IanHarris6/USB3-HUB/Schematics (PDFs)/USB-C-Hub.pdf

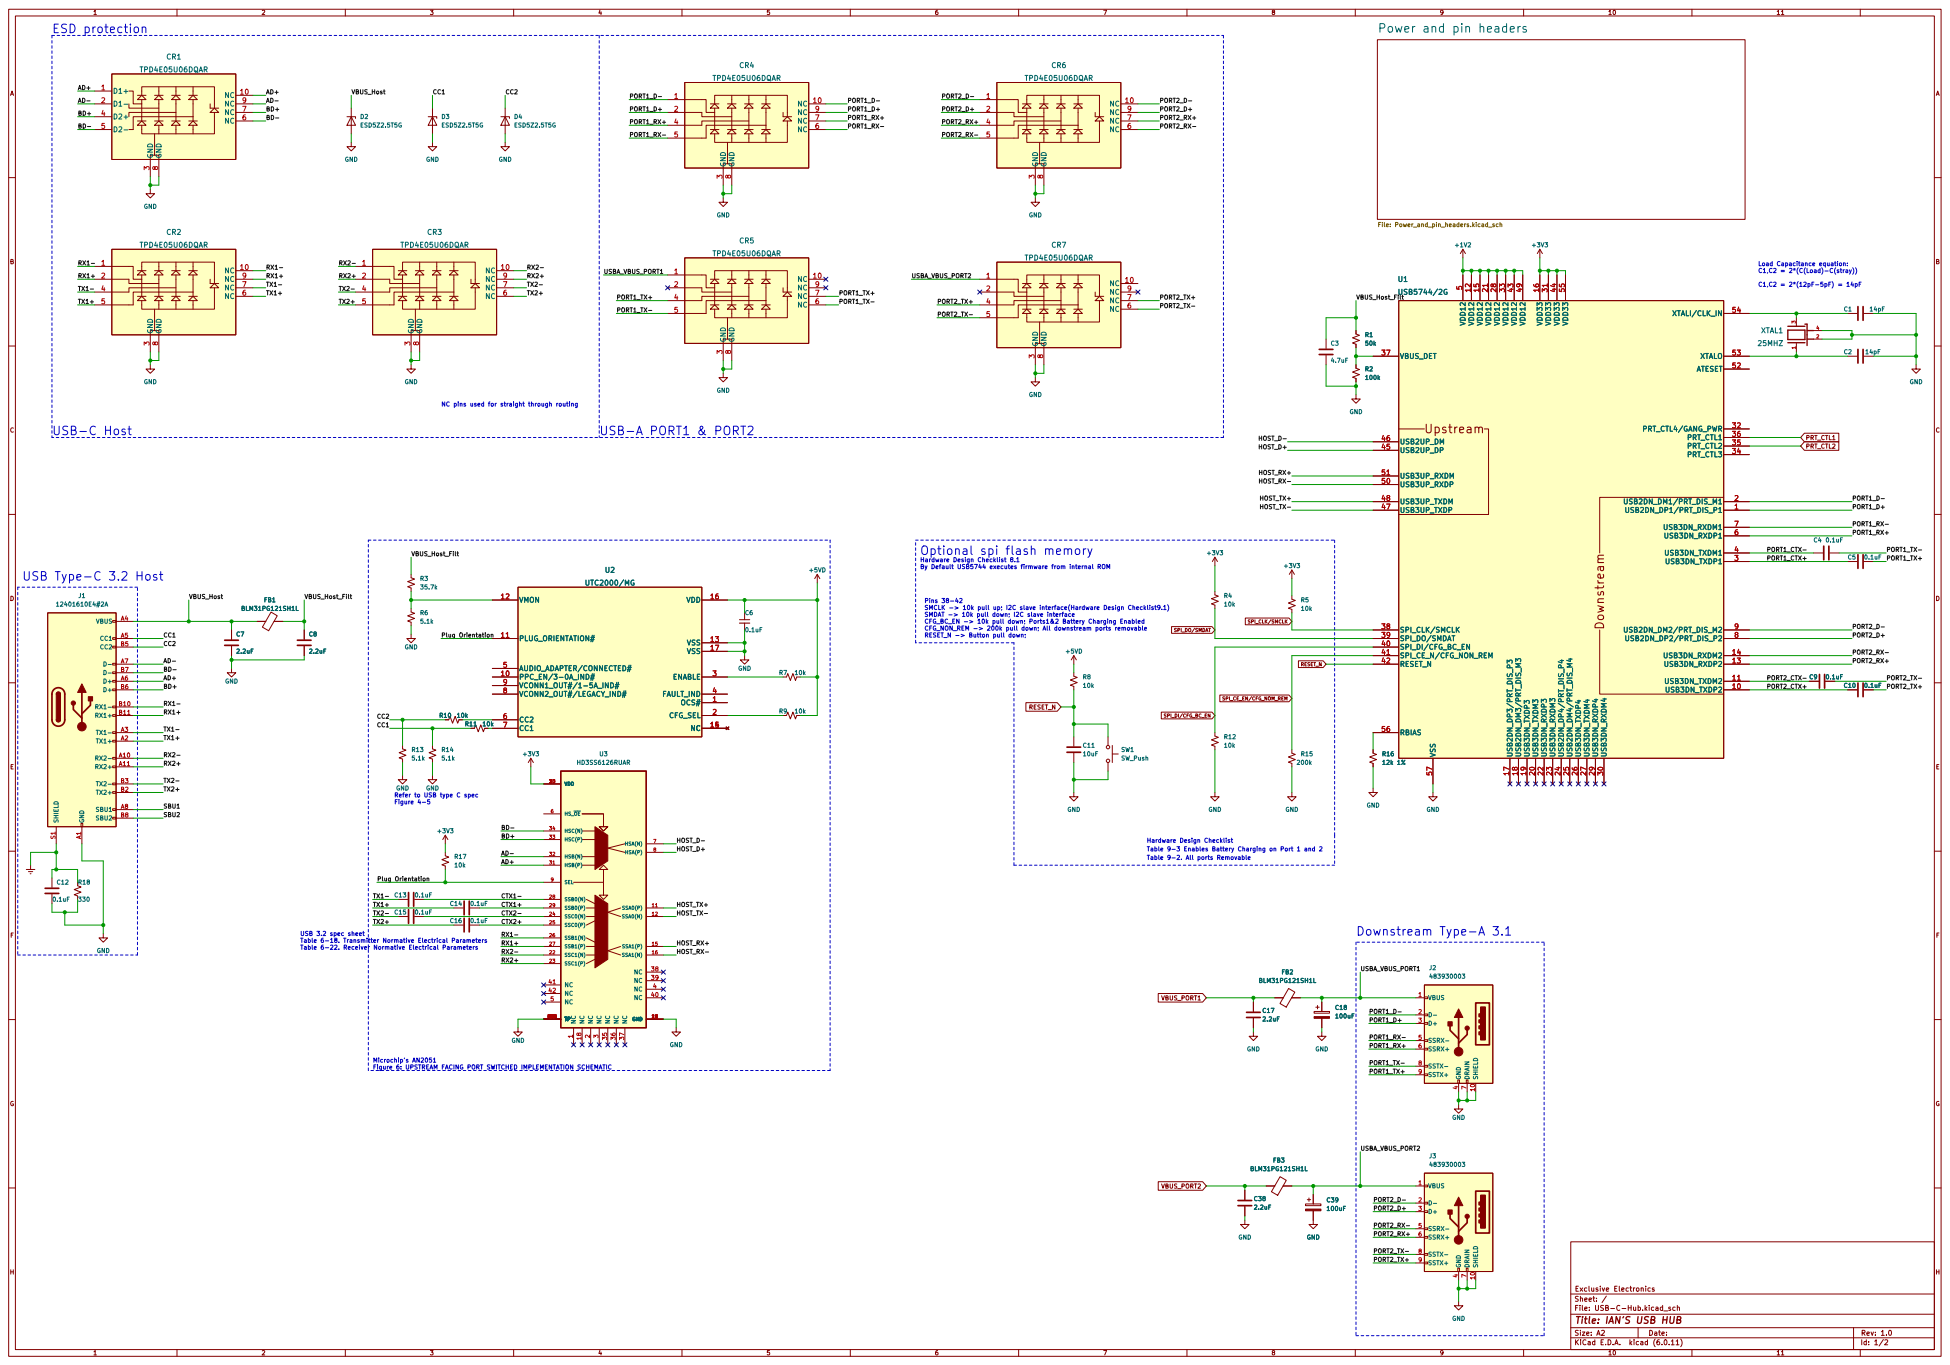
[picture p1: page 1]

3 NC 35 NC 36 NC 37 NC 38 NC 39 NC 4 NC 40 NC 41 NC 42 NC 5 U3 HD3SS6126RUAR

File: USB-C-Hub.kicad_sch Sheet: / Exclusive Electronics

Id: 1/2 Title: IAN'S USB HUB
