IanHarris6/USB3-HUB/Schematics (PDFs)/USB-C-Hub-Power and pin headers.pdf

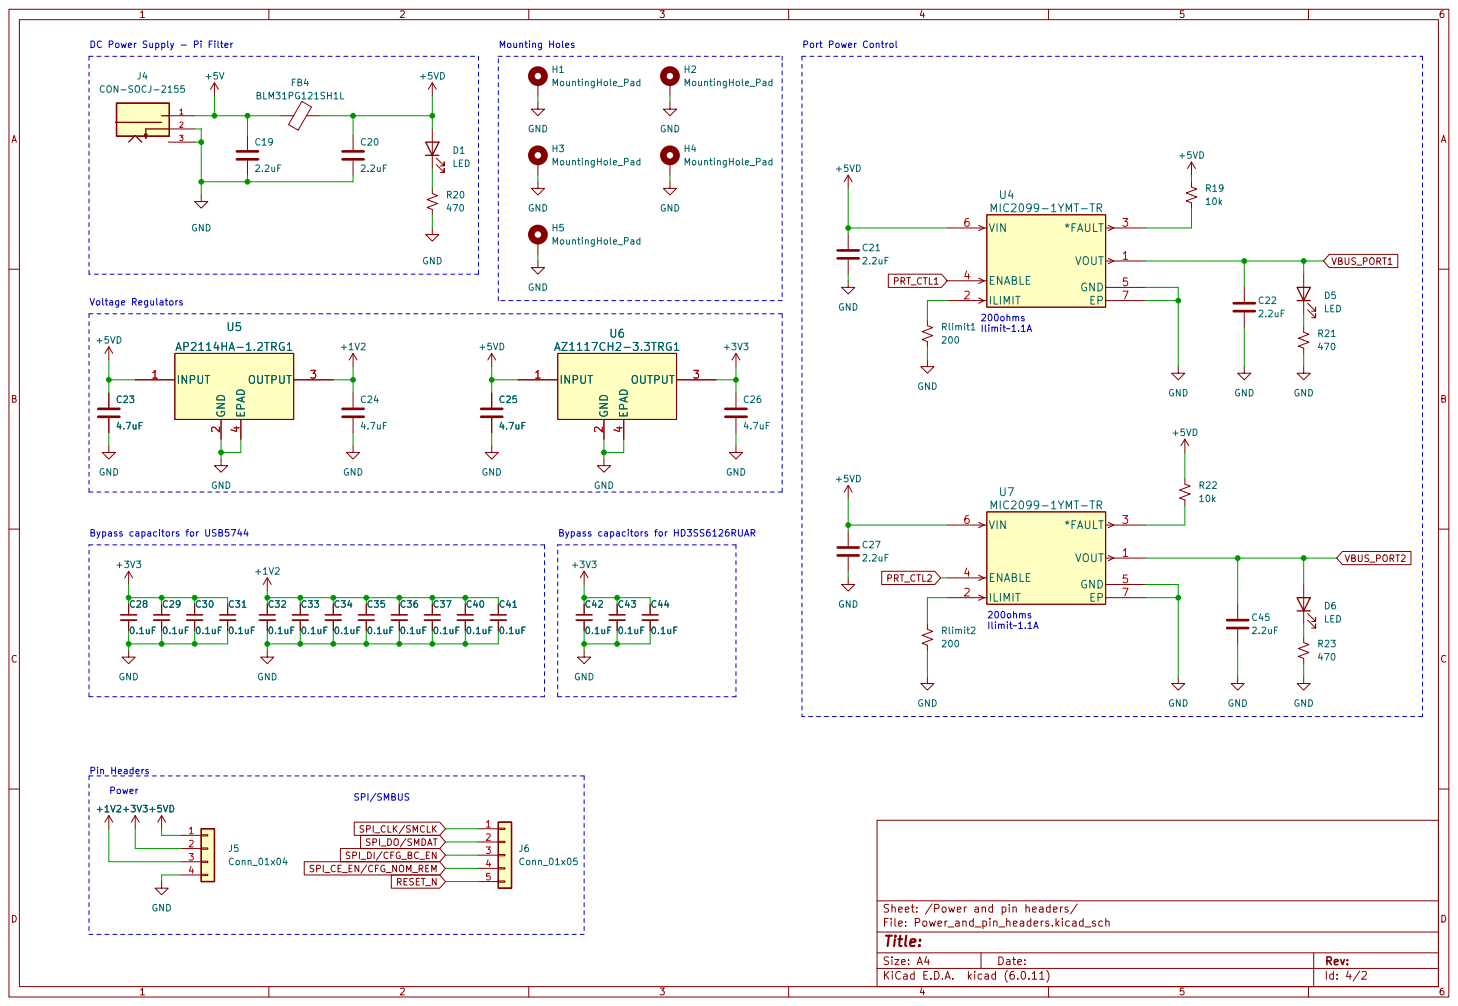
[picture p2: page 1]

DC Power Supply - Pi Filter
