IanHarris6/USB3-HUB/V2/Schematics (PDFs)/USB-C-Hub v2-Power and pin headers.pdf

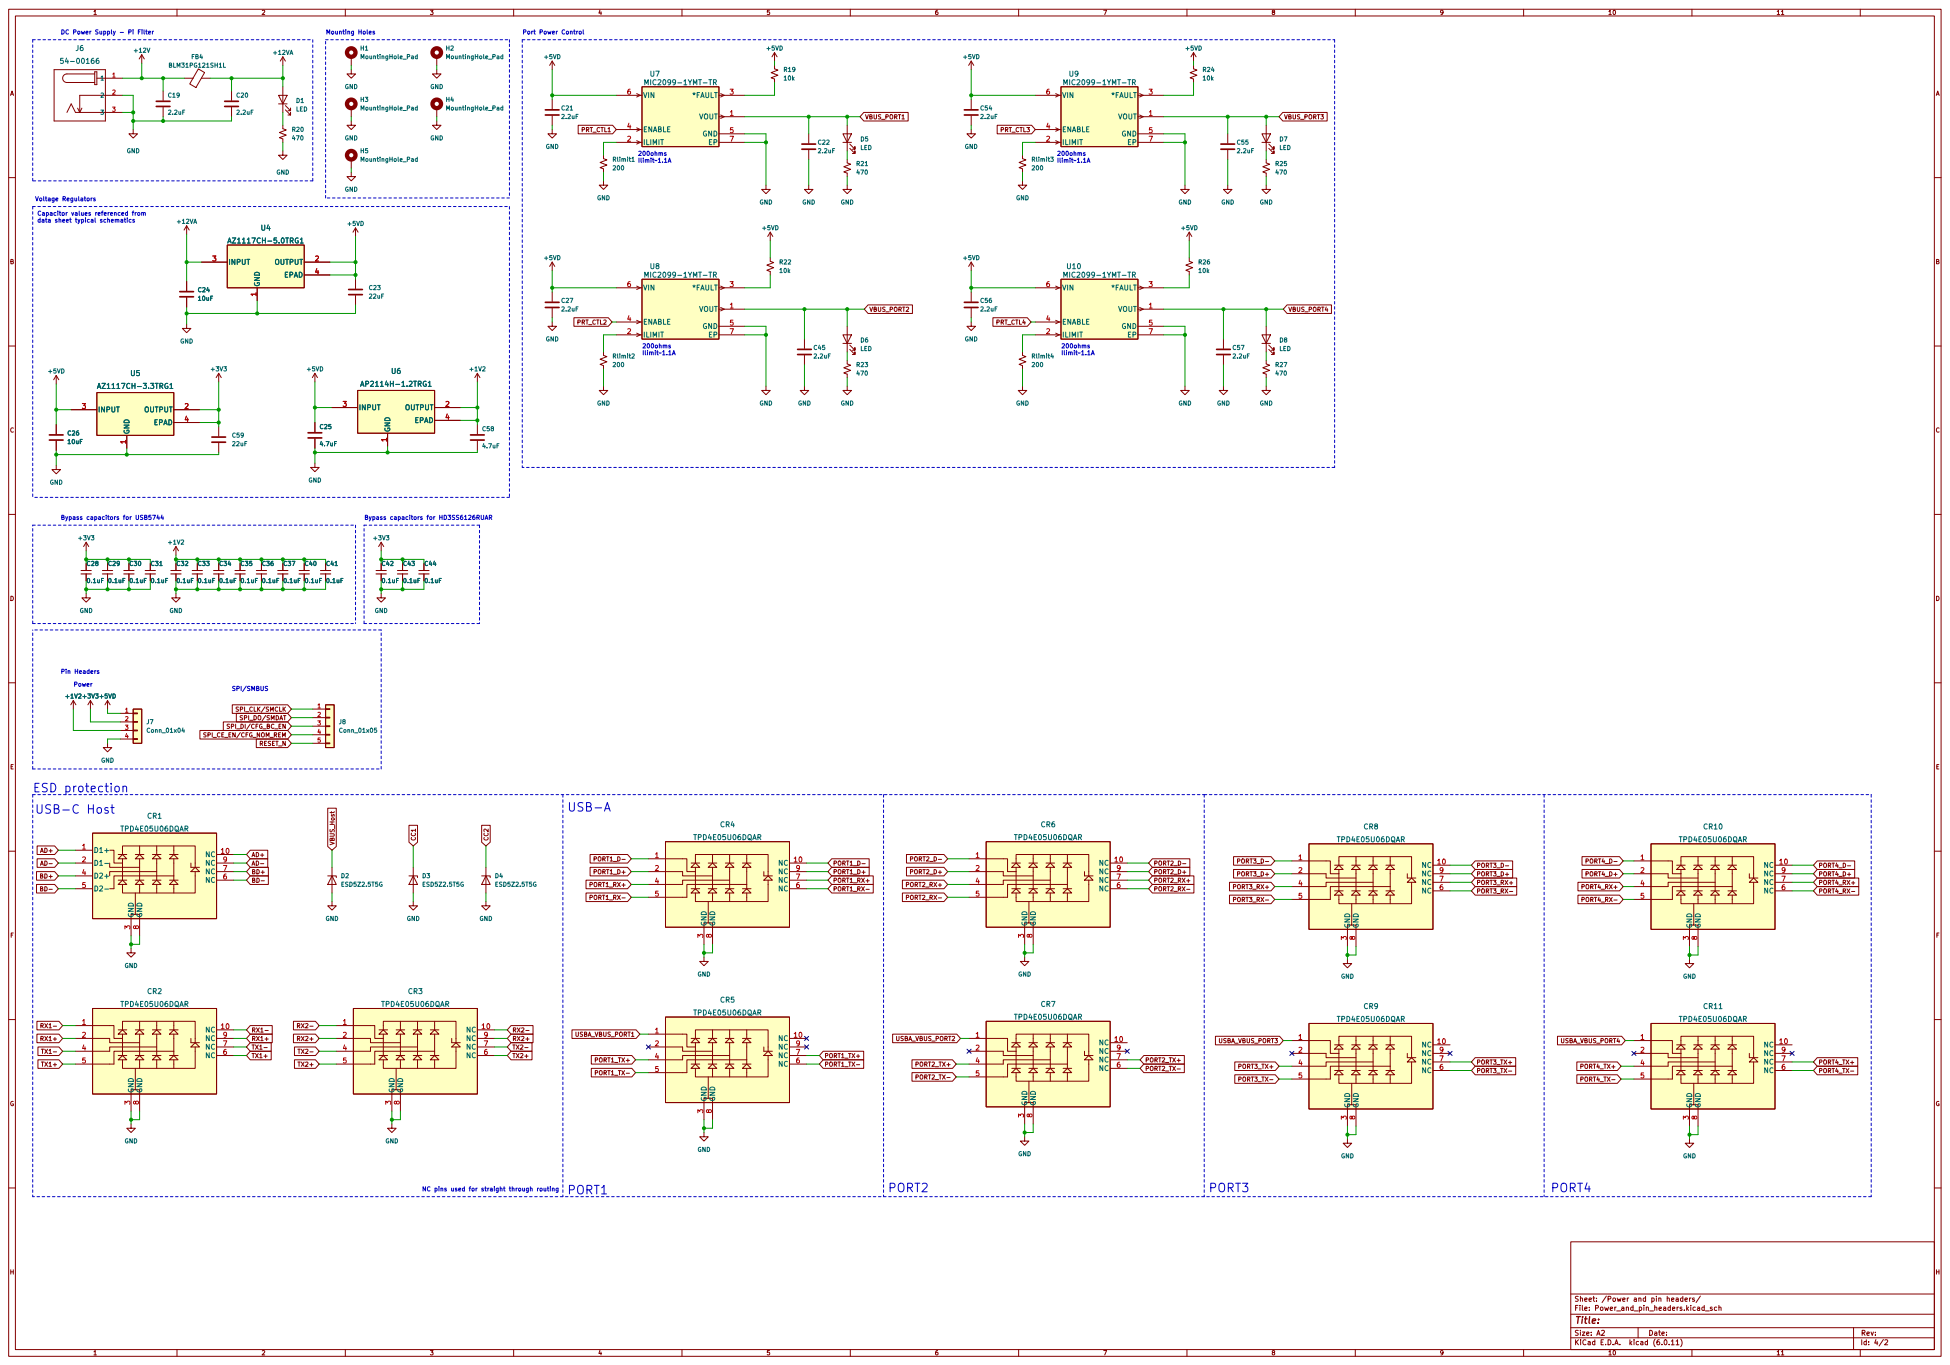
[picture p3: page 1]

Ilimit~1.1A Mounting Holes Voltage Regulators

DC Power Supply - Pi Filter
