IanHarris6/USB3-HUB/V2/Schematics (PDFs)/USB-C-Hub v2.pdf

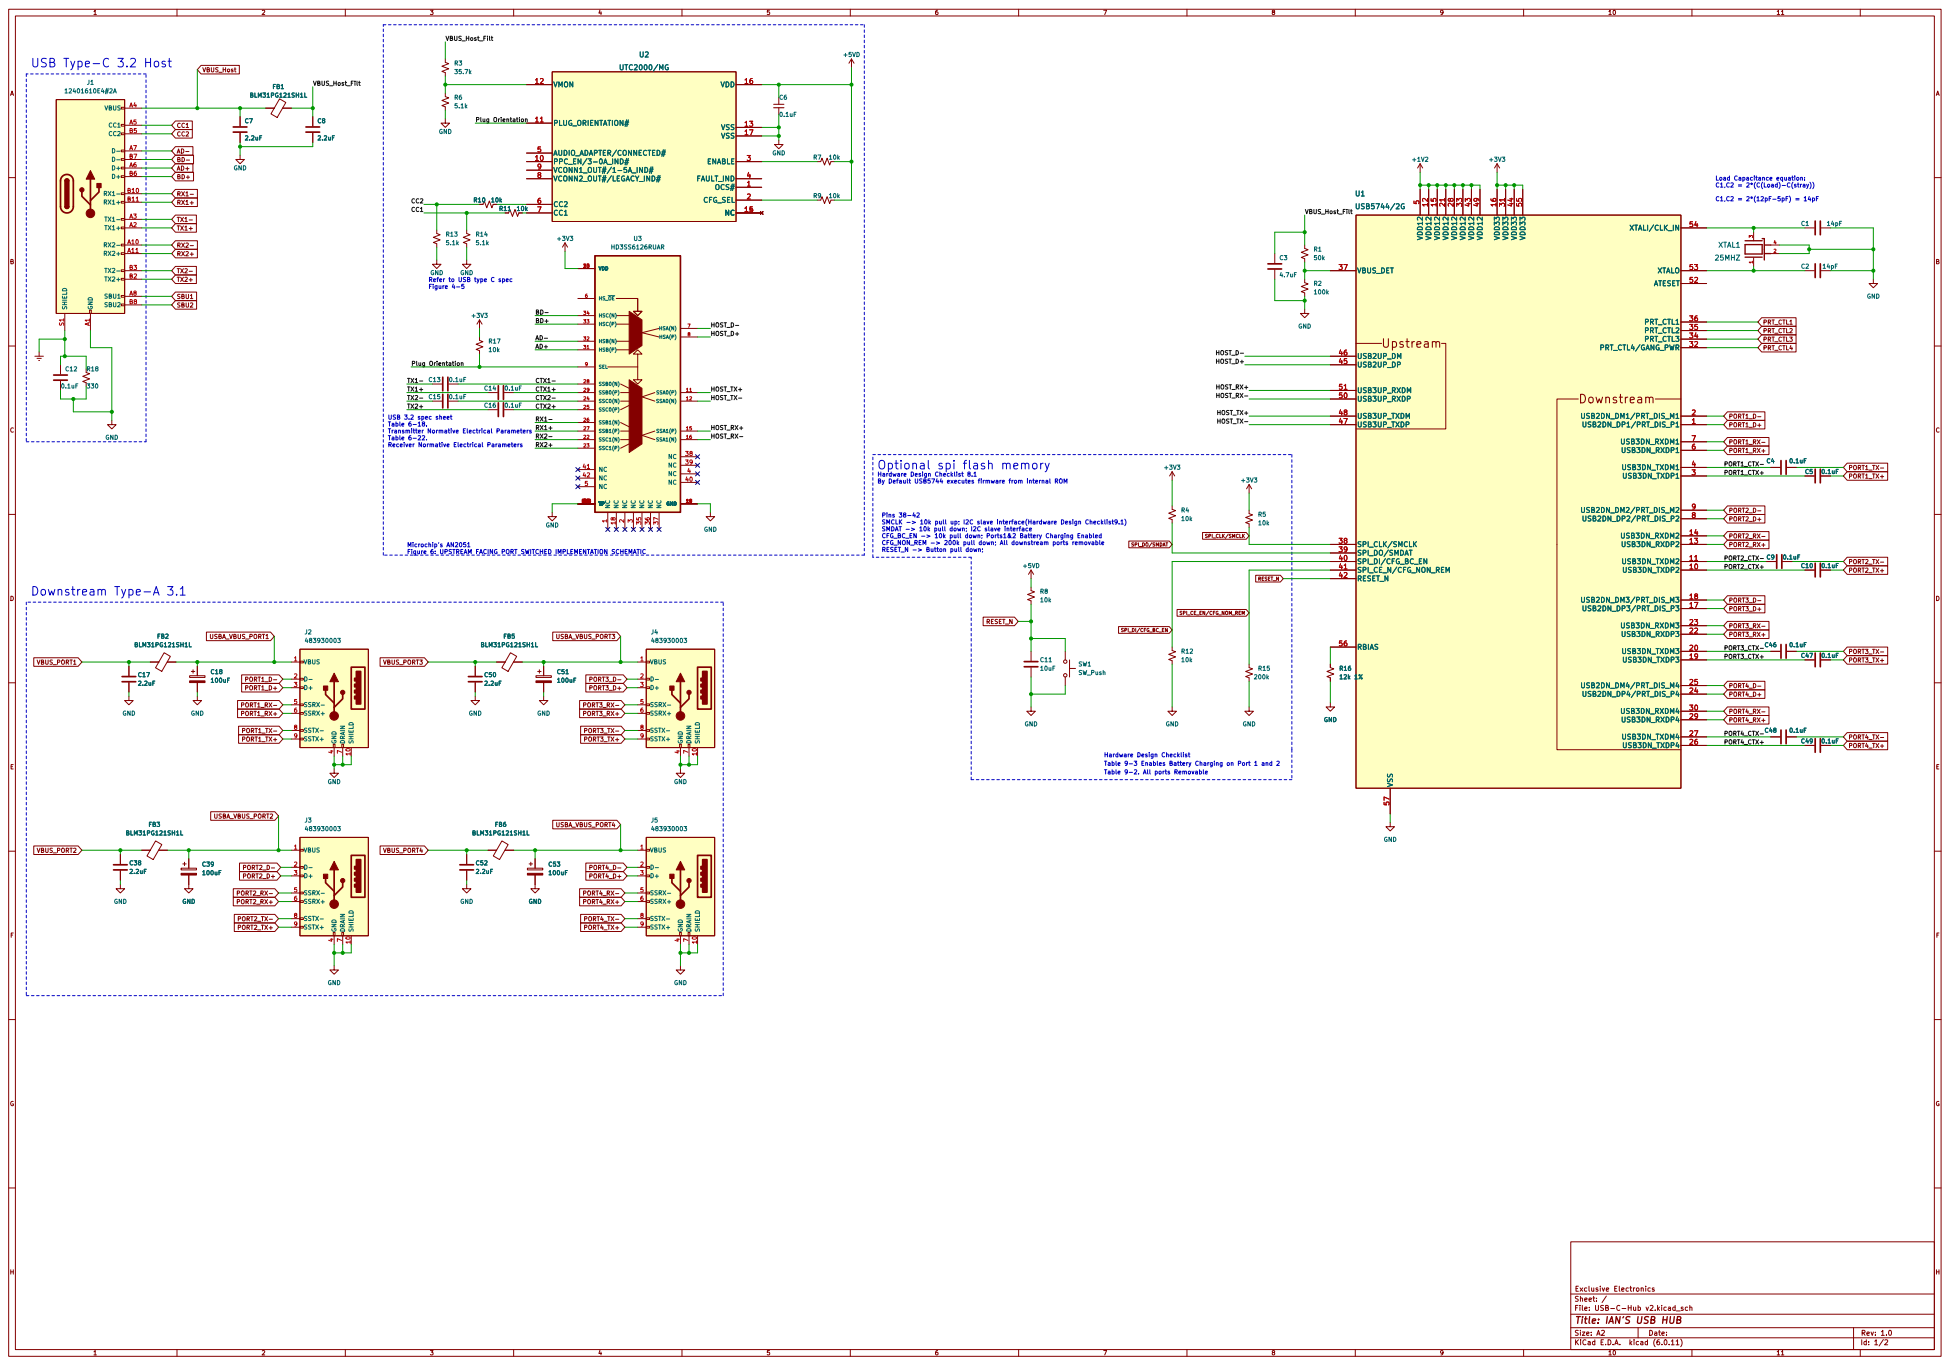
[picture p4: page 1]

VBUS_Host SBU1 SBU2 TX2+ TX2- RX1+ TX1- RX2- RX2+ TX1+ RX1- BD+ CC2 AD- AD+ BD- CC1

3 NC 35 NC 36 NC 37 NC 38 NC 39 NC 4 NC 40 NC 41 NC 42 NC 5 U3 HD3SS6126RUAR
VDD

Optional spi flash memory

Id: 1/2 Title: IAN'S USB HUB


Ilimit~1.1A Mounting Holes Voltage Regulators

DC Power Supply - Pi Filter
