IanHarris6/USB3-HUB/KiCad-Files/USB-C-Hub.kicad_pcb

## KiCad design KiCad-Files/USB-C-Hub.kicad_pcb (2023-09-19)

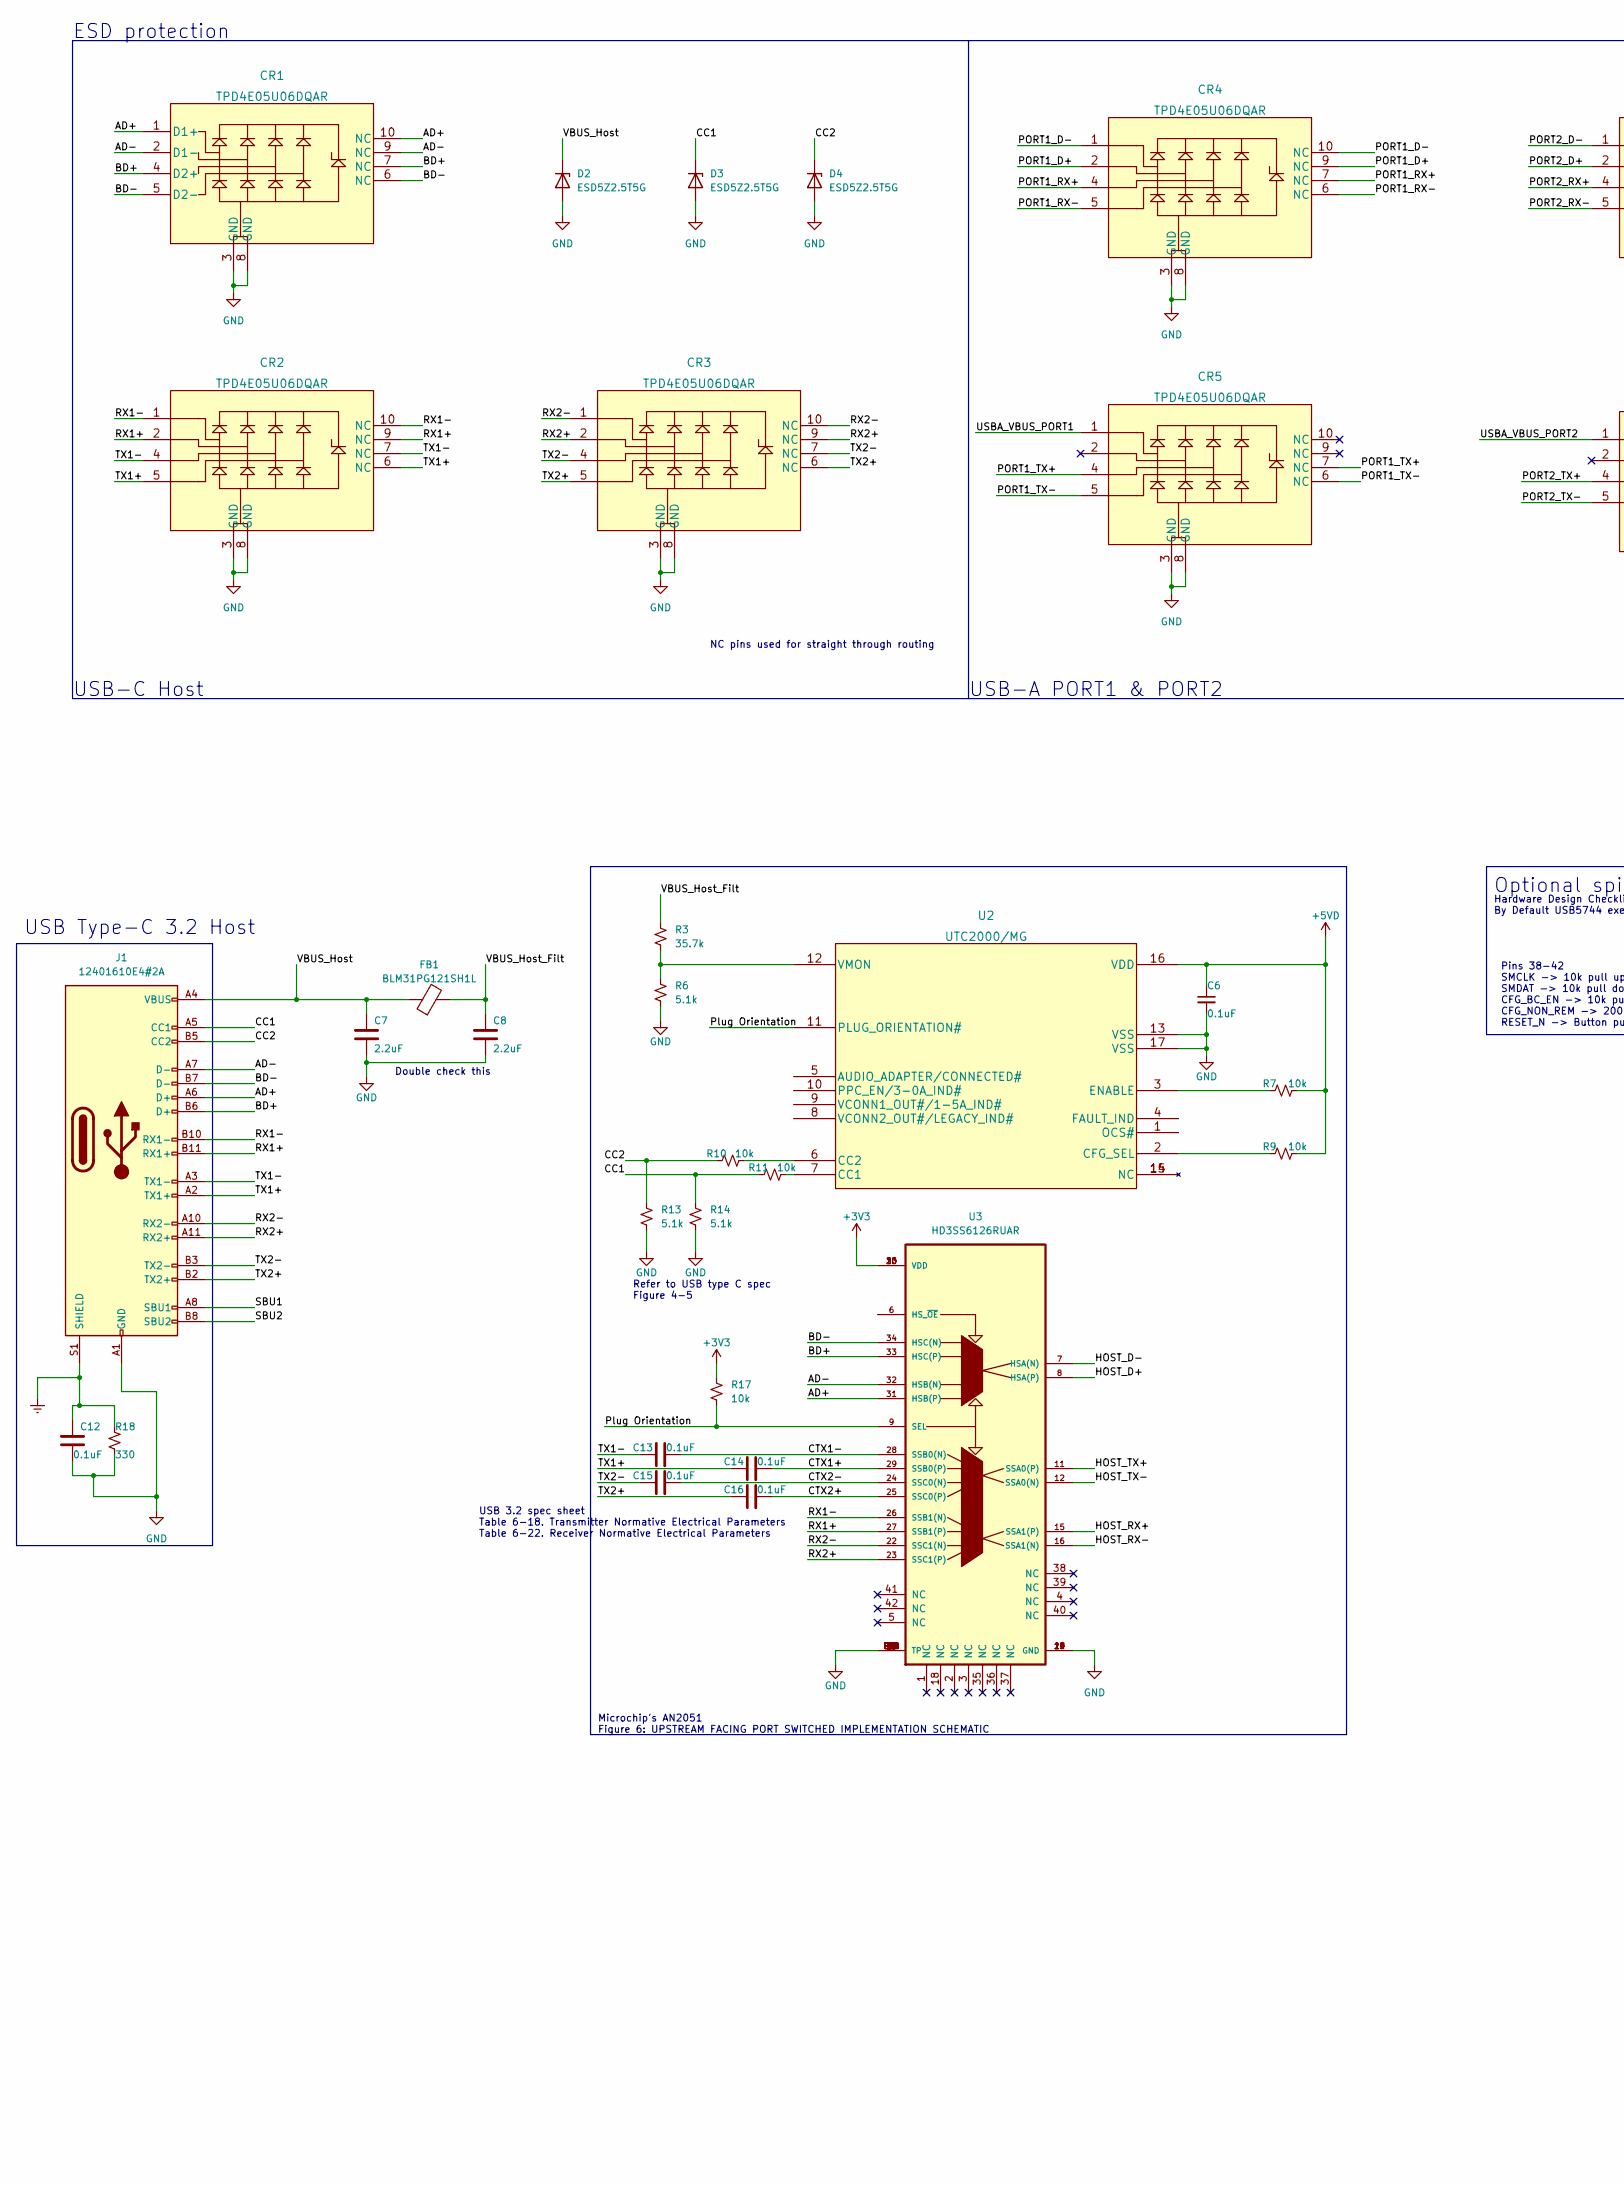
[picture p5: schematic USB-C-Hub.kicad_sch, IAN'S USB HUB, part in row 1, column 1]

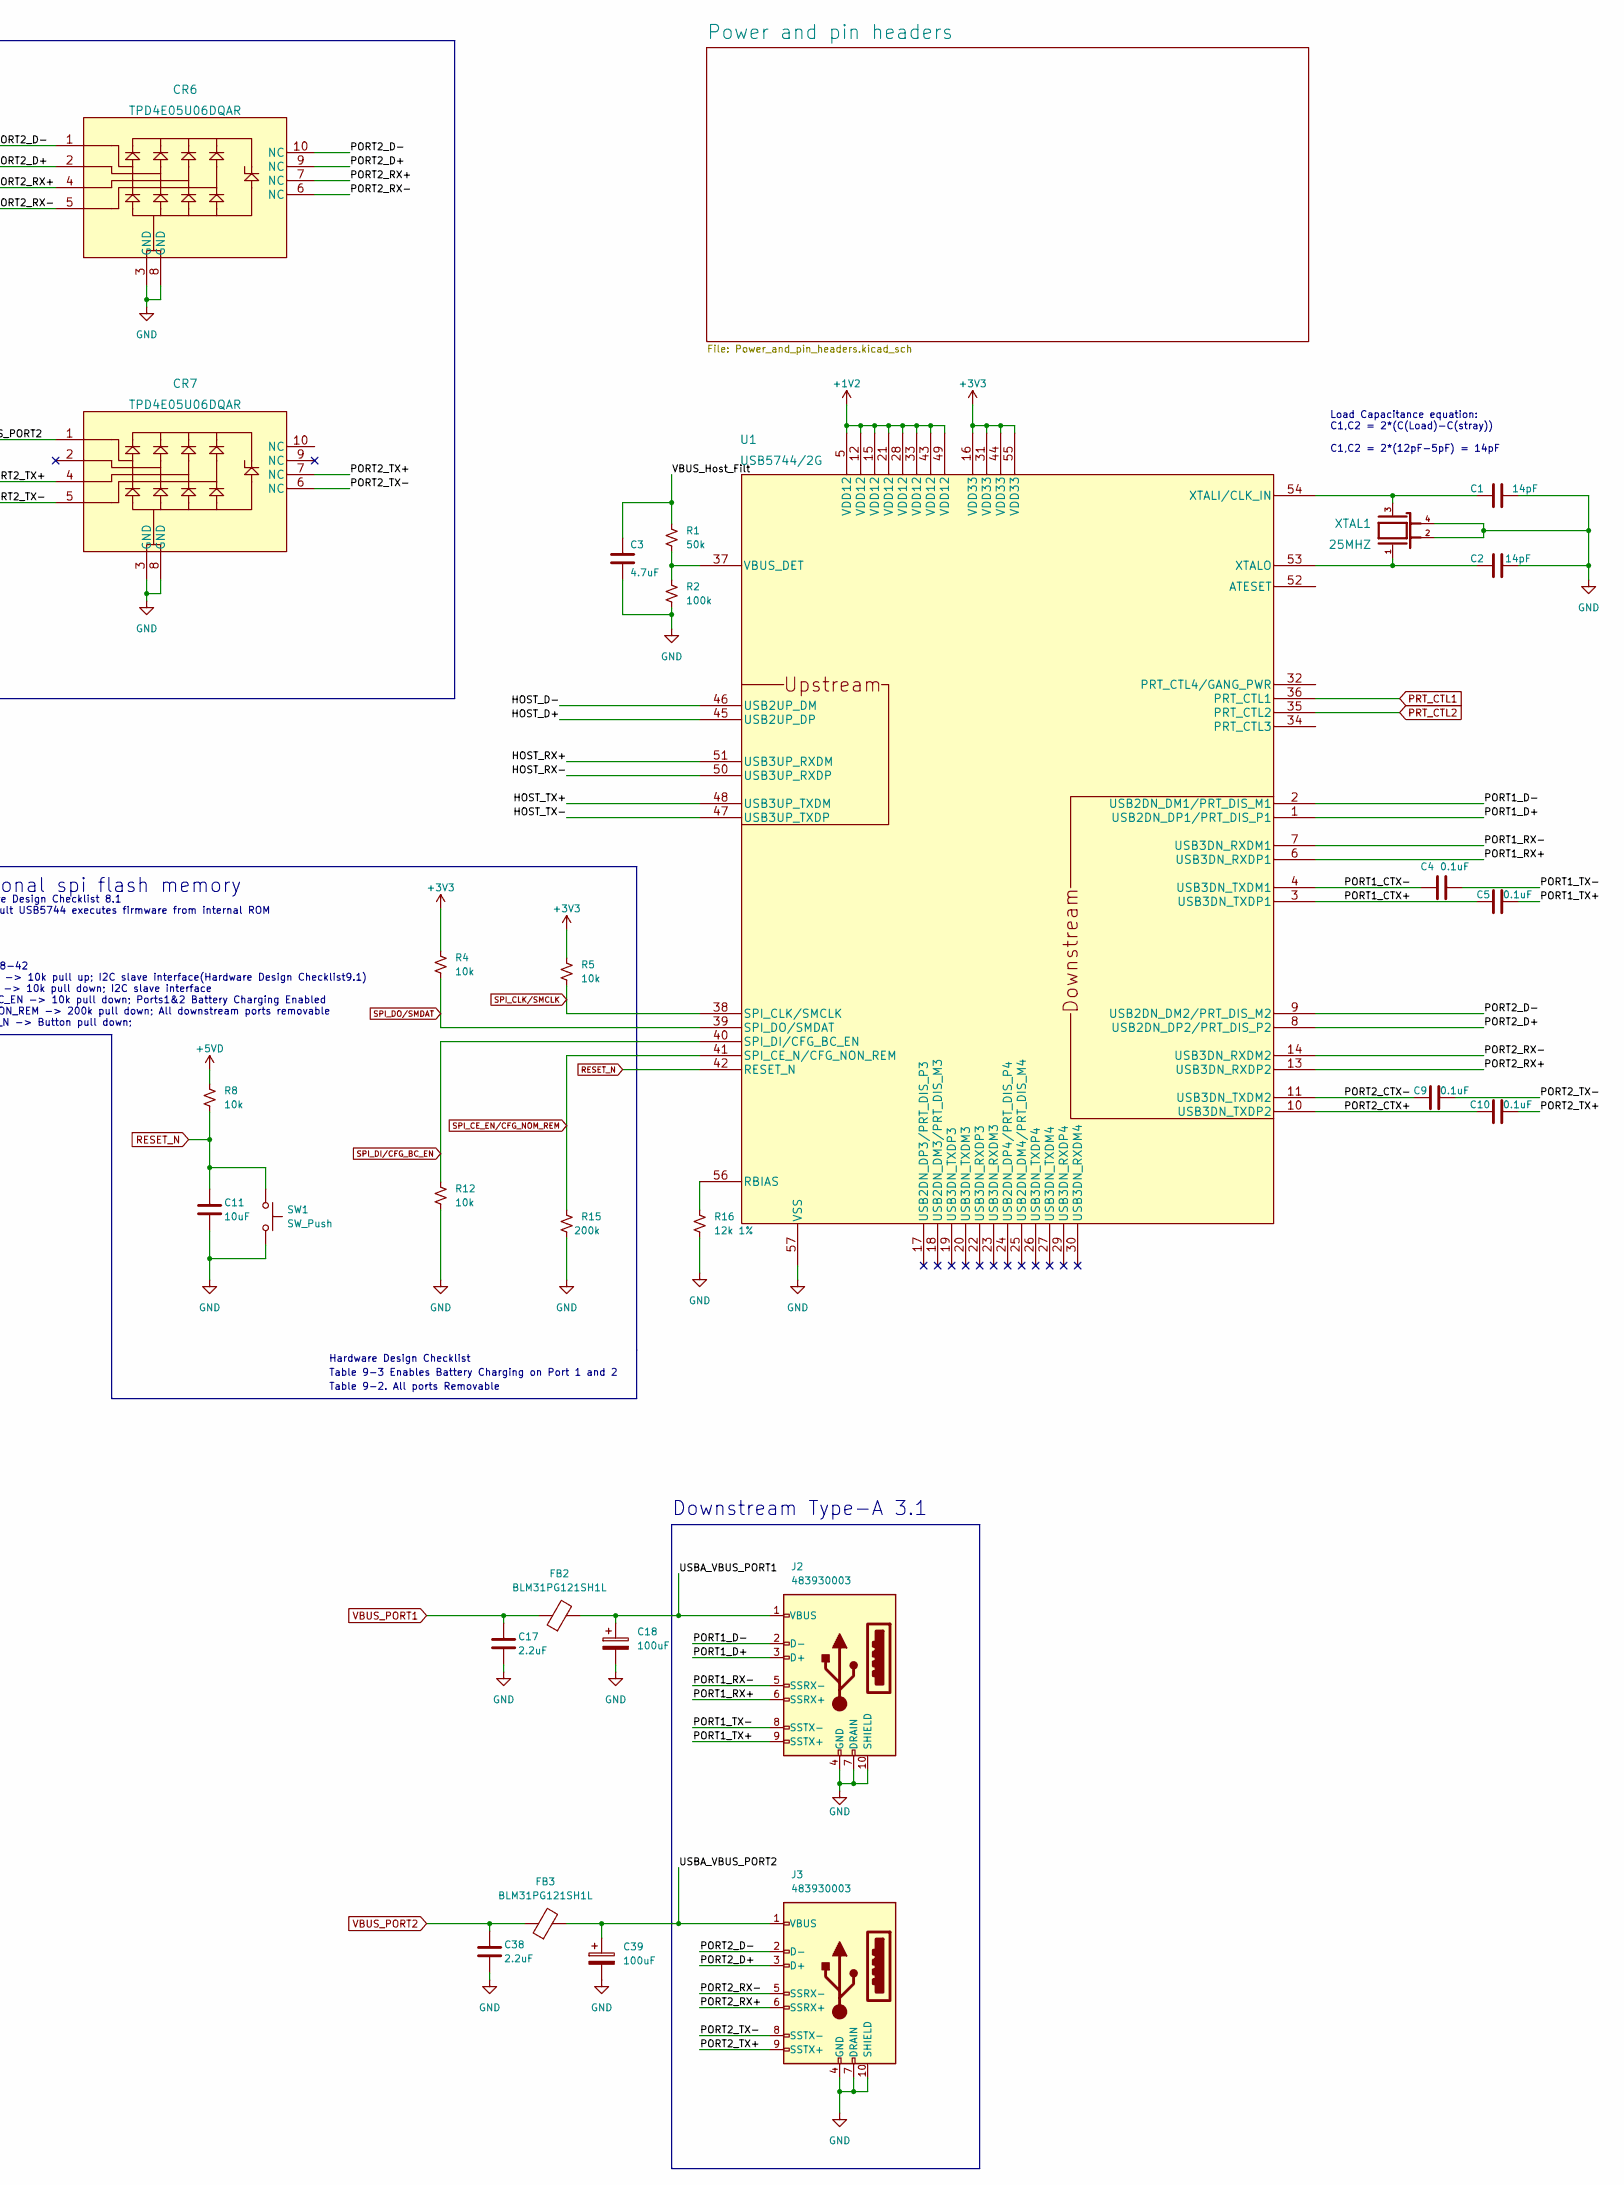
[picture p6: schematic USB-C-Hub.kicad_sch, IAN'S USB HUB, part in row 1, column 2]

Parts:
C1, C2: 14pF; R_0402_1005Metric
C3: 4.7uF; C_0603_1608Metric; MFR# CL10A475KQ8NNNC
C4, C5, C6, C12, C13, C14, C15, C16: 0.1uF; C_0402_1005Metric; MFR# CL05A104KA5NNNC
C7, C8: 2.2uF; C_0603_1608Metric
C9, C10: 0.1uF; C_0402_1005Metric
C11: 10uF; C_0603_1608Metric; MFR# CL10A106KQ8NNNC
C17, C38: 2.2uF; C_0603_1608Metric; MFR# CL10A225KO8NNNC
C18: 100uF; CP_Elec_10x10.5; MFR# MAL215097101E3
C39: 100uF; CP_Elec_10x10.5; MFG# MAL215097101E3
CR1, CR2, CR3, CR4, CR5, CR6, CR7: TPD4E05U06DQAR; USON-10_2.5x1.0mm_P0.5mm
D2, D3, D4: ESD5Z2.5T5G; D_SOD-523
FB1, FB2, FB3: BLM31PG121SH1L; R_1206_3216Metric
J1: 12401610E4#2A; USB_C_Receptacle_Amphenol_12401610E4-2A
J2, J3: 483930003; USB3_A_Molex_48393-001
R1: 50k; R_0402_1005Metric
R2: 100k; R_0402_1005Metric
R3: 35.7k; R_0402_1005Metric
R4, R5, R7, R8, R9, R10, R11, R12, R17: 10k; R_0402_1005Metric
R6, R13, R14: 5.1k; R_0402_1005Metric
R15: 200k; R_0402_1005Metric; MFG# RC0402JR-07200KL
R16: 12k 1%; R_0402_1005Metric
R18: 330; R_0402_1005Metric
SW1: SW_Push; SW_SPST_PTS645; MFR# PTS645SK43SMTR92 LFS
U1: USB5744/2G; VQFN56_2G_MCH
U2: UTC2000/MG; 16-pinQFN3x3; MFR# UTC2000/MG
U3: HD3SS6126RUAR; QFN50P900X350X80-43N
XTAL1: 25MHZ; ECS-250-12-33Q-JES-TR_ECS; MFR# ECS-250-12-33Q-JES-TR

Connections:
+1V2: U1.5 (VDD12), U1.12 (VDD12), U1.15 (VDD12), U1.21 (VDD12), U1.28 (VDD12), U1.33 (VDD12), U1.43 (VDD12), U1.49 (VDD12); also elsewhere on the board
+3V3: R4.1, R5.1, R17.1, U1.16 (VDD33), U1.31 (VDD33), U1.44 (VDD33), U1.55 (VDD33), U3.13 (VDD), U3.20 (VDD), U3.30 (VDD); also elsewhere on the board
+5VD: C6.1, R7.1, R8.1, R9.1, U2.16 (VDD); also elsewhere on the board
/AD+: CR1.1 (D1+), CR1.10 (NC), J1.A6 (D+), U3.31 (HSB(P))
/AD-: CR1.2 (D1-), CR1.9 (NC), J1.A7 (D-), U3.32 (HSB(N))
/BD+: CR1.4 (D2+), CR1.7 (NC), J1.B6 (D+), U3.33 (HSC(P))
/BD-: CR1.5 (D2-), CR1.6 (NC), J1.B7 (D-), U3.34 (HSC(N))
/CC1: D3.1 (K), J1.A5 (CC1), R11.2, R14.1
/CC2: D4.1 (K), J1.B5 (CC2), R10.2, R13.1
/CTX1+: C14.2, U3.29 (SSB0(P))
/CTX1-: C13.2, U3.28 (SSB0(N))
/CTX2+: C16.2, U3.25 (SSC0(P))
/CTX2-: C15.2, U3.24 (SSC0(N))
/HOST_D+: U1.45 (USB2UP_DP), U3.8 (HSA(P))
/HOST_D-: U1.46 (USB2UP_DM), U3.7 (HSA(N))
/HOST_RX+: U1.51 (USB3UP_RXDM), U3.15 (SSA1(P))
/HOST_RX-: U1.50 (USB3UP_RXDP), U3.16 (SSA1(N))
/HOST_TX+: U1.48 (USB3UP_TXDM), U3.11 (SSA0(P))
/HOST_TX-: U1.47 (USB3UP_TXDP), U3.12 (SSA0(N))
/PORT1_CTX+: C5.1, U1.3 (USB3DN_TXDP1)
/PORT1_CTX-: C4.1, U1.4 (USB3DN_TXDM1)
/PORT1_D+: CR4.2, CR4.9 (NC), J2.3 (D+), U1.1 (USB2DN_DP1/PRT_DIS_P1)
/PORT1_D-: CR4.1, CR4.10 (NC), J2.2 (D-), U1.2 (USB2DN_DM1/PRT_DIS_M1)
/PORT1_RX+: CR4.4, CR4.7 (NC), J2.6 (SSRX+), U1.6 (USB3DN_RXDP1)
/PORT1_RX-: CR4.5, CR4.6 (NC), J2.5 (SSRX-), U1.7 (USB3DN_RXDM1)
/PORT1_TX+: C5.2, CR5.4, CR5.7 (NC), J2.9 (SSTX+)
/PORT1_TX-: C4.2, CR5.5, CR5.6 (NC), J2.8 (SSTX-)
/PORT2_CTX+: C10.1, U1.10 (USB3DN_TXDP2)
/PORT2_CTX-: C9.1, U1.11 (USB3DN_TXDM2)
/PORT2_D+: CR6.2, CR6.9 (NC), J3.3 (D+), U1.8 (USB2DN_DP2/PRT_DIS_P2)
/PORT2_D-: CR6.1, CR6.10 (NC), J3.2 (D-), U1.9 (USB2DN_DM2/PRT_DIS_M2)
/PORT2_RX+: CR6.4, CR6.7 (NC), J3.6 (SSRX+), U1.13 (USB3DN_RXDP2)
/PORT2_RX-: CR6.5, CR6.6 (NC), J3.5 (SSRX-), U1.14 (USB3DN_RXDM2)
/PORT2_TX+: C10.2, CR7.4, CR7.7 (NC), J3.9 (SSTX+)
/PORT2_TX-: C9.2, CR7.5, CR7.6 (NC), J3.8 (SSTX-)
/Plug Orientation: R17.2, U2.11 (PLUG_ORIENTATION#), U3.9 (SEL)
/RX1+: CR2.2, CR2.9 (NC), J1.B11 (RX1+), U3.27 (SSB1(P))
/RX1-: CR2.1, CR2.10 (NC), J1.B10 (RX1-), U3.26 (SSB1(N))
/RX2+: CR3.2, CR3.9 (NC), J1.A11 (RX2+), U3.23 (SSC1(P))
/RX2-: CR3.1, CR3.10 (NC), J1.A10 (RX2-), U3.22 (SSC1(N))
/SBU1: J1.A8 (SBU1)
/SBU2: J1.B8 (SBU2)
/TX1+: C14.1, CR2.5, CR2.6 (NC), J1.A2 (TX1+)
/TX1-: C13.1, CR2.4, CR2.7 (NC), J1.A3 (TX1-)
/TX2+: C16.1, CR3.5, CR3.6 (NC), J1.B2 (TX2+)
/TX2-: C15.1, CR3.4, CR3.7 (NC), J1.B3 (TX2-)
/USBA_VBUS_PORT1: C18.1, CR5.1, FB2.2, J2.1 (VBUS)
/USBA_VBUS_PORT2: C39.1, CR7.1, FB3.2, J3.1 (VBUS)
/VBUS_Host: C7.1, D2.1 (K), FB1.1, J1.A4 (VBUS), J1.A9 (VBUS), J1.B4 (VBUS), J1.B9 (VBUS)
/VBUS_Host_Filt: C3.1, C8.1, FB1.2, R1.1, R3.1
Earth: C12.1, J1.S1 (SHIELD), R18.1
GND: C1.1, C2.1, C3.2, C6.2, C7.2, C8.2, C11.2, C12.2, C17.2, C18.2, C38.2, C39.2, CR1.3 (GND), CR1.8 (GND), CR2.3 (GND), CR2.8 (GND), CR3.3 (GND), CR3.8 (GND), CR4.3 (GND), CR4.8 (GND), CR5.3 (GND), CR5.8 (GND), CR6.3 (GND), CR6.8 (GND), CR7.3 (GND), CR7.8 (GND), D2.2 (A), D3.2 (A), D4.2 (A), J1.A1 (GND), J1.A12 (GND), J1.B1 (GND), J1.B12 (GND), J2.4 (GND), J2.7 (DRAIN), J2.10 (SHIELD), J3.4 (GND), J3.7 (DRAIN), J3.10 (SHIELD), R2.2, R6.2, R12.2, R13.2, R14.2, R15.2, R16.2, R18.2, SW1.2, U1.57 (VSS), U2.13 (VSS), U2.17 (VSS), U3.10 (GND), U3.14 (GND), U3.17 (GND), U3.19 (GND), U3.21 (GND), U3.43 (TP), U3.E1 (TP), U3.E2 (TP), U3.E3 (TP), U3.E4 (TP), U3.E5 (TP), U3.E6 (TP), U3.E7 (TP), U3.E8 (TP), U3.E9 (TP), U3.E10 (TP), U3.E11 (TP), U3.E12 (TP), U3.E13 (TP), U3.E14 (TP), XTAL1.2, XTAL1.4; also elsewhere on the board
unnamed: C1.2, U1.54 (XTALI/CLK_IN), XTAL1.3
unnamed: C2.2, U1.53 (XTALO), XTAL1.1
unnamed: R1.2, R2.1, U1.37 (VBUS_DET)
unnamed: R3.2, R6.1, U2.12 (VMON)
unnamed: R7.2, U2.3 (ENABLE)
unnamed: R9.2, U2.2 (CFG_SEL)
unnamed: R10.1, U2.6 (CC2)
unnamed: R11.1, U2.7 (CC1)
unnamed: R16.1, U1.56 (RBIAS)
PRT_CTL1: U1.36 (PRT_CTL1); also elsewhere on the board
PRT_CTL2: U1.35 (PRT_CTL2); also elsewhere on the board
RESET_N: C11.1, R8.2, SW1.1, U1.42 (RESET_N); also elsewhere on the board
SPI_CE_EN/CFG_NOM_REM: R15.1, U1.41 (SPI_CE_N/CFG_NON_REM); also elsewhere on the board
SPI_CLK/SMCLK: R5.2, U1.38 (SPI_CLK/SMCLK); also elsewhere on the board
SPI_DI/CFG_BC_EN: R12.1, U1.40 (SPI_DI/CFG_BC_EN); also elsewhere on the board
SPI_DO/SMDAT: R4.2, U1.39 (SPI_DO/SMDAT); also elsewhere on the board
VBUS_PORT1: C17.1, FB2.1; also elsewhere on the board
VBUS_PORT2: C38.1, FB3.1; also elsewhere on the board

Notes on the sheet:
ESD protection
Load Capacitance equation: C1,C2 = 2*(C(Load)-C(stray)) C1,C2 = 2*(12pF-5pF) = 14pF
USB 3.2 spec sheet Table 6-18. Transmitter Normative Electrical Parameters Table 6-22. Receiver Normative Electrical Parameters
Downstream Type-A 3.1
Refer to USB type C spec Figure 4-5
Pins 38-42 SMCLK -> 10k pull up; I2C slave interface(Hardware Design Checklist9.1) SMDAT -> 10k pull down; I2C slave interface CFG_BC_EN -> 10k pull down; Ports1&2 Battery Charging Enabled CFG_NON_REM -> 200k pull down; All downstream ports removable RESET_N -> Button pull down;
Optional spi flash memory
USB-C Host
USB Type-C 3.2 Host
Table 9-3 Enables Battery Charging on Port 1 and 2
NC pins used for straight through routing
Table 9-2. All ports Removable
Hardware Design Checklist 8.1 By Default USB5744 executes firmware from internal ROM
Hardware Design Checklist
USB-A PORT1 & PORT2
Double check this
Microchip's AN2051 Figure 6: UPSTREAM FACING PORT SWITCHED IMPLEMENTATION SCHEMATIC

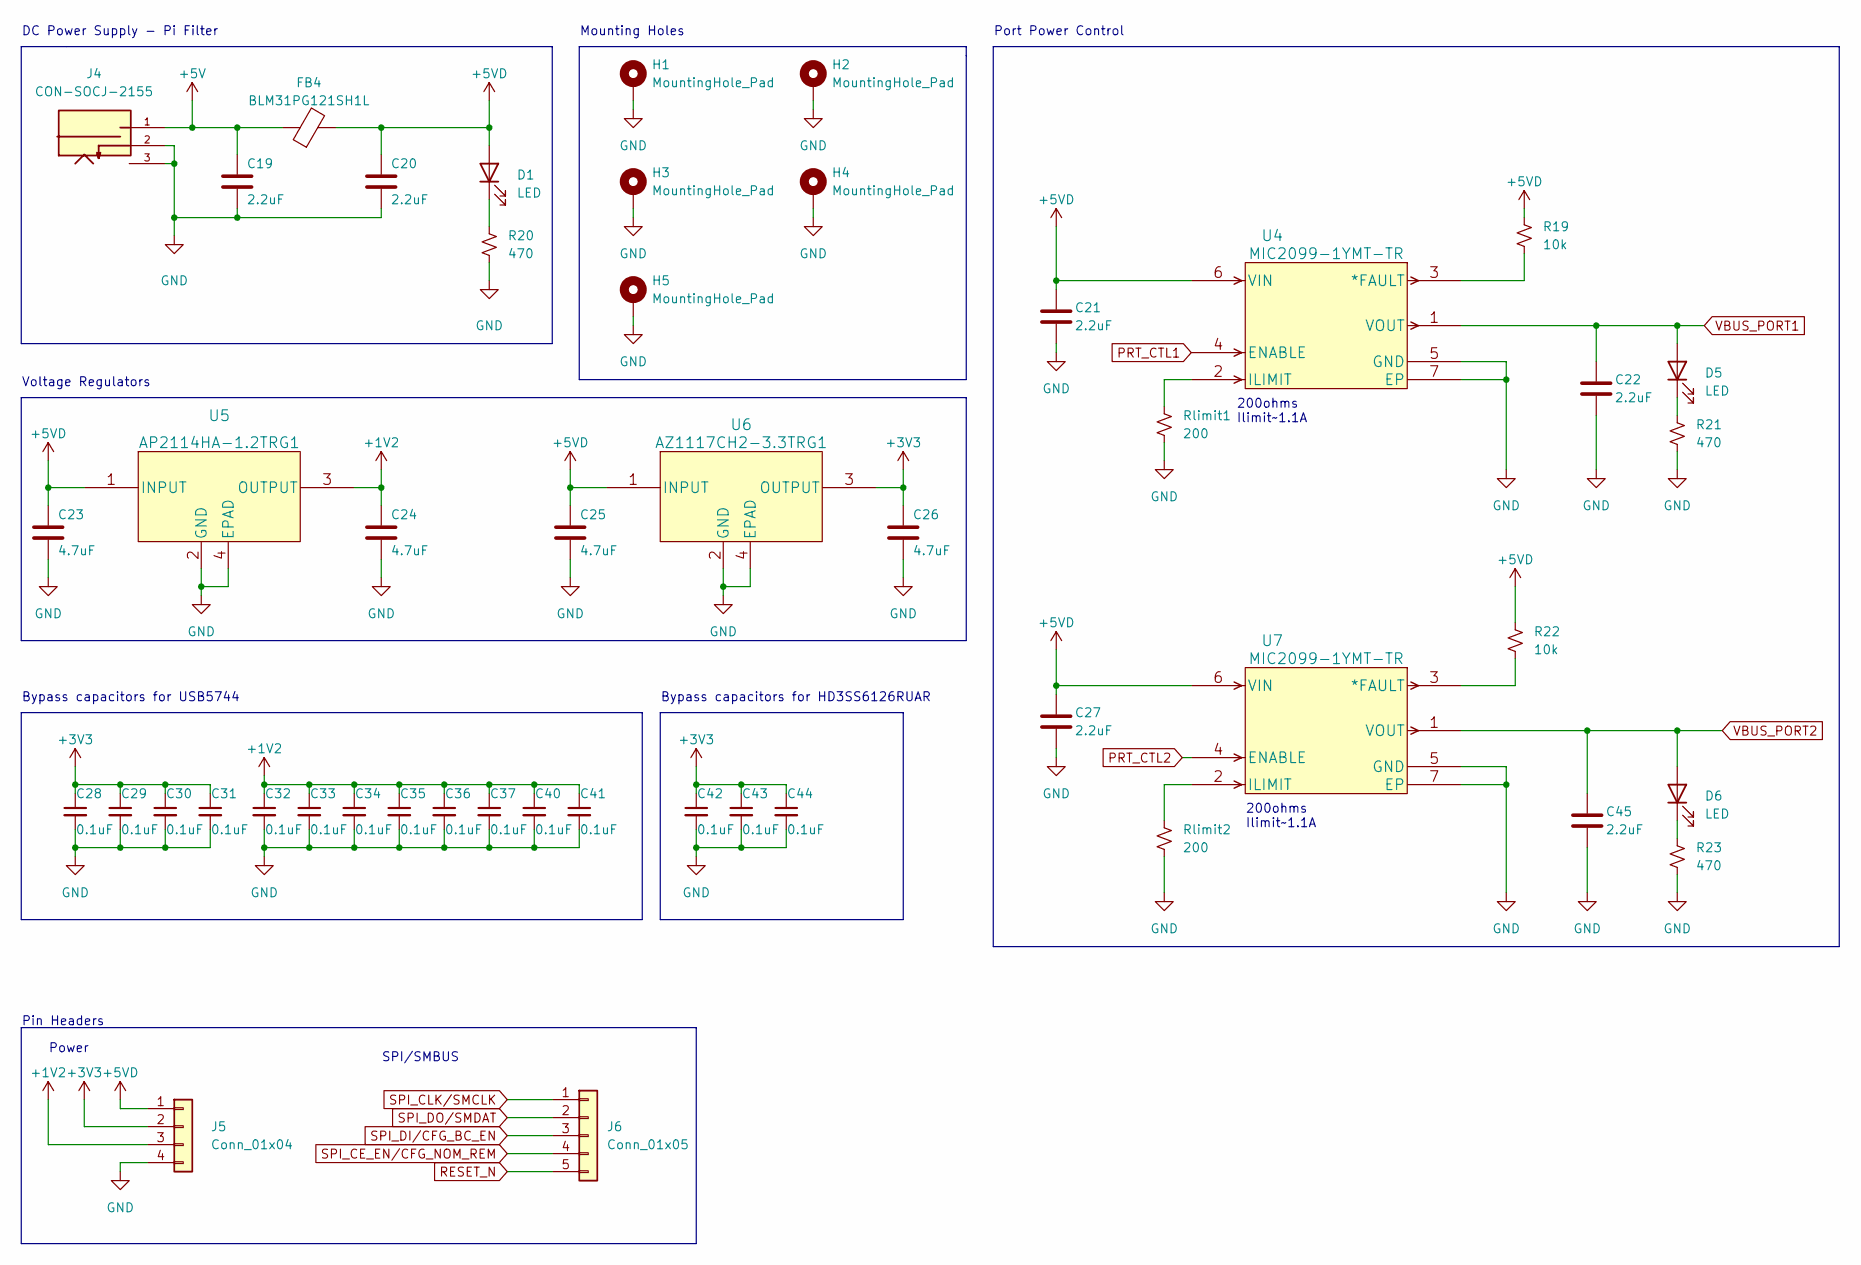
[picture p7: schematic Power_and_pin_headers.kicad_sch]

Parts:
C19, C20, C21, C22, C27, C45: 2.2uF; C_0603_1608Metric; MFR# CL10A225KO8NNNC
C23, C24, C25, C26: 4.7uF; C_0603_1608Metric; MFR# CL10A475KQ8NNNC
C28, C29, C30, C31, C32, C33, C34, C35, C36, C37, C40, C41, C42, C43, C44: 0.1uF; C_0402_1005Metric; MFR# CL05A104KA5NNNC
D1, D5, D6: LED; LED_0603_1608Metric; MFR# LTST-C191KRKT
FB4: BLM31PG121SH1L; R_1206_3216Metric
H1, H2, H3, H4, H5: MountingHole_Pad; MountingHole_3mm_Pad_Via
J4: CON-SOCJ-2155; GRAVITECH_CON-SOCJ-2155; PARTREV NA
J5: Conn_01x04; PinSocket_1x04_P2.54mm_Vertical
J6: Conn_01x05; PinSocket_1x05_P2.54mm_Vertical
R19, R22: 10k; R_0402_1005Metric
R20, R21, R23: 470; R_0402_1005Metric; MFR# WR04X4700FTL
Rlimit1, Rlimit2: 200; R_0402_1005Metric
U4, U7: MIC2099-1YMT-TR; TMLF-6_MT_MCH
U5: AP2114HA-1.2TRG1; SOT-223
U6: AZ1117CH2-3.3TRG1; SOT-223

Connections:
+1V2: C24.1, C32.1, C33.1, C34.1, C35.1, C36.1, C37.1, C40.1, C41.1, J5.3, U5.3 (OUTPUT); also elsewhere on the board
+3V3: C26.1, C28.1, C29.1, C30.1, C31.1, C42.1, C43.1, C44.1, J5.2, U6.3 (OUTPUT); also elsewhere on the board
+5V: C19.1, FB4.1, J4.1
+5VD: C20.1, C21.1, C23.1, C25.1, C27.1, D1.2 (A), FB4.2, J5.1, R19.1, R22.1, U4.6 (VIN), U5.1 (INPUT), U6.1 (INPUT), U7.6 (VIN); also elsewhere on the board
GND: C19.2, C20.2, C21.2, C22.2, C23.2, C24.2, C25.2, C26.2, C27.2, C28.2, C29.2, C30.2, C31.2, C32.2, C33.2, C34.2, C35.2, C36.2, C37.2, C40.2, C41.2, C42.2, C43.2, C44.2, C45.2, H1.1, H2.1, H3.1, H4.1, H5.1, J4.2, J4.3, J5.4, R20.2, R21.2, R23.2, Rlimit1.2, Rlimit2.2, U4.5 (GND), U4.7 (EP), U5.2 (GND), U5.4 (EPAD), U6.2 (GND), U6.4 (EPAD), U7.5 (GND), U7.7 (EP); also elsewhere on the board
unnamed: D1.1 (K), R20.1
unnamed: D5.1 (K), R21.1
unnamed: D6.1 (K), R23.1
unnamed: R19.2, U4.3 (*FAULT)
unnamed: R22.2, U7.3 (*FAULT)
unnamed: Rlimit1.1, U4.2 (ILIMIT)
unnamed: Rlimit2.1, U7.2 (ILIMIT)
PRT_CTL1: U4.4 (ENABLE); also elsewhere on the board
PRT_CTL2: U7.4 (ENABLE); also elsewhere on the board
RESET_N: J6.5; also elsewhere on the board
SPI_CE_EN/CFG_NOM_REM: J6.4; also elsewhere on the board
SPI_CLK/SMCLK: J6.1; also elsewhere on the board
SPI_DI/CFG_BC_EN: J6.3; also elsewhere on the board
SPI_DO/SMDAT: J6.2; also elsewhere on the board
VBUS_PORT1: C22.1, D5.2 (A), U4.1 (VOUT); also elsewhere on the board
VBUS_PORT2: C45.1, D6.2 (A), U7.1 (VOUT); also elsewhere on the board

Notes on the sheet:
DC Power Supply - Pi Filter
Power
200ohms Ilimit~1.1A
SPI/SMBUS
Bypass capacitors for USB5744
Pin Headers
Port Power Control
Mounting Holes
Bypass capacitors for HD3SS6126RUAR
Voltage Regulators

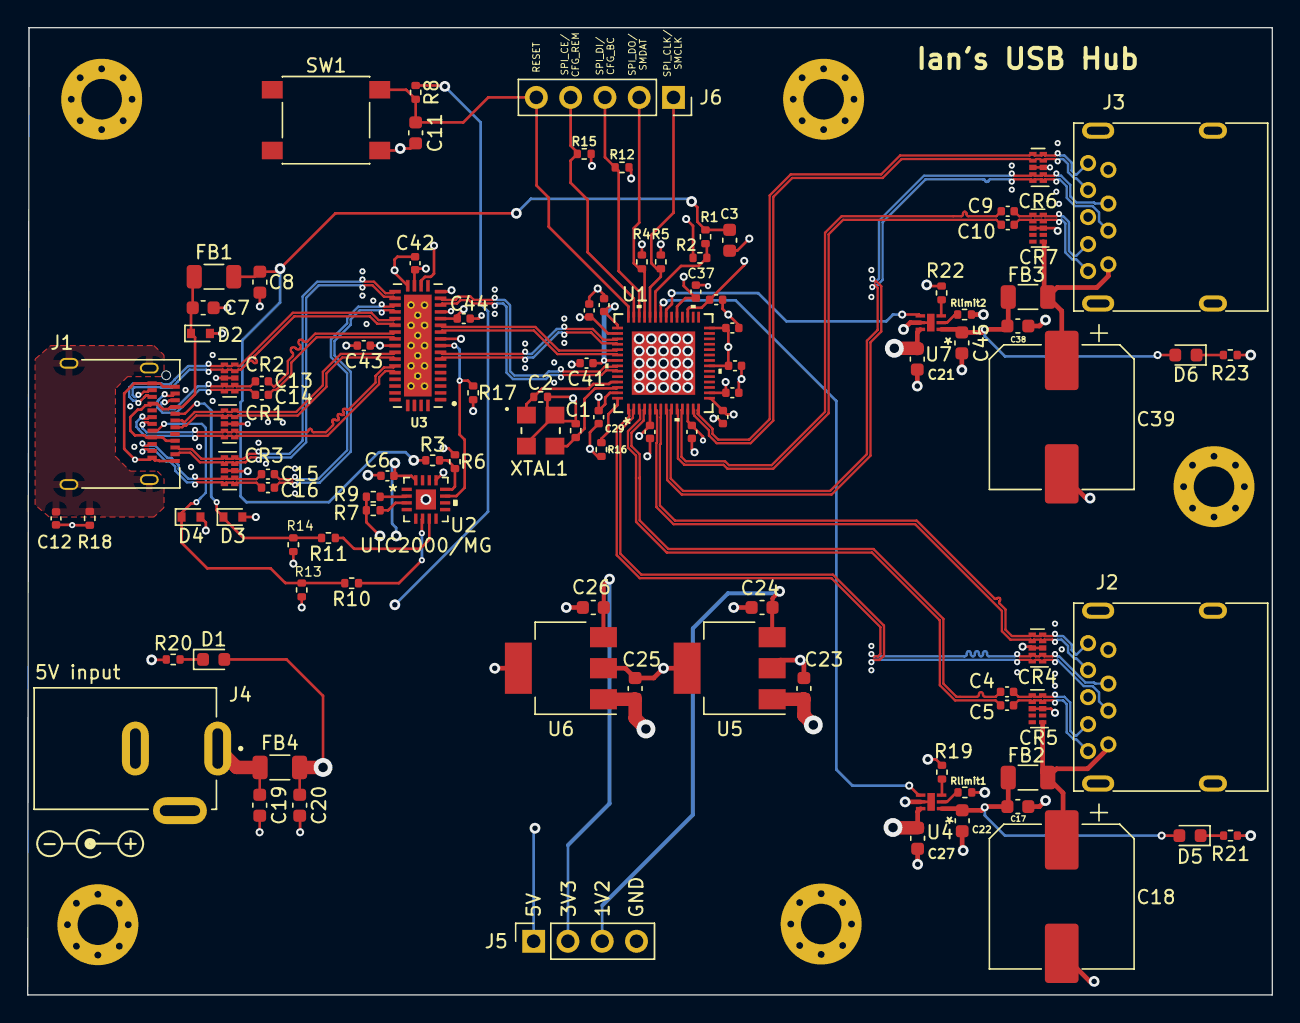
[picture p8: board USB-C-Hub.kicad_pcb from above]

Board: 4 copper layers, 92.2 x 71.7 mm, 107 parts (0 on the bottom side), 76 nets.
