IanHarris6/USB3-HUB/(commit log)

2023-05-25 Schematic and PCB first commit
    [USB-C-Hub.kicad_pcb, USB-C-Hub.kicad_sch]
2023-09-13 Create gerbers
2023-09-13 Adding Gerber Files
    [USB-C-Hub-B_Cu.gbr, USB-C-Hub-B_Mask.gbr, USB-C-Hub-Edge_Cuts.gbr, USB-C-Hub-F_Cu.gbr, USB-C-Hub-F_Mask.gbr, USB-C-Hub-F_Silkscreen.gbr, USB-C-Hub-In1_Cu.gbr, USB-C-Hub-In2_Cu.gbr]
2023-09-19 Added silkscreen and made power planes a bit wider
    [Power_and_pin_headers.kicad_sch, USB-C-Hub.kicad_pcb, USB-C-Hub.kicad_sch]
2023-09-19 Added silkscreen
    also made power planes a little bit wider
2023-09-19 Upload BOM
    [BOM.csv]
2023-09-19 Added Silkscreen
    Widened power planes a little
    [USB-C-Hub-B_Cu.gbr, USB-C-Hub-B_Mask.gbr, USB-C-Hub-Edge_Cuts.gbr, USB-C-Hub-F_Cu.gbr, USB-C-Hub-F_Mask.gbr, USB-C-Hub-F_Silkscreen.gbr, USB-C-Hub-In1_Cu.gbr, USB-C-Hub-In2_Cu.gbr]
2023-09-25 Add Schematics
